Matthew-Otto/tiny-riscv/APR/tiny-riscv_layout.gif

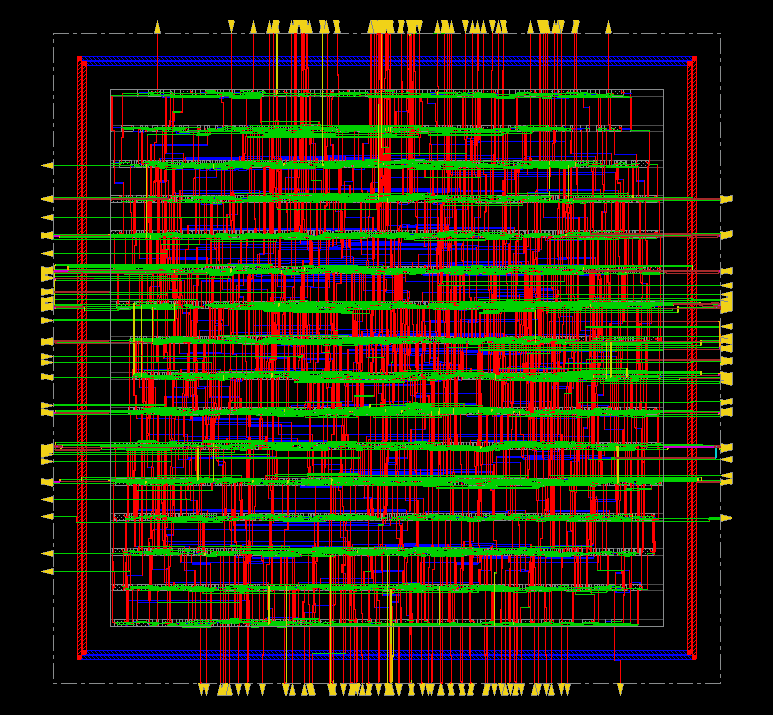
APR/tiny-riscv_layout.gif
