Matthew-Otto/tiny-riscv/RTL/top.sv

// Top module that includes a register file for simulation

module top (
    input  logic        clk,
    input  logic        rst,
    // instruction port
    output logic [31:0] i_addr,
    input  logic [31:0] i_rd_data,
    // data port
    output logic [31:0] d_addr,
    output logic [3:0]  d_we,
    output logic [31:0] d_wr_data,
    input  logic [31:0] d_rd_data
);

    // performance counters
    logic stall_execution;
    logic [31:0] cycle_count;
    logic [31:0] exec_count;

    assign stall_execution = core.control_i.flush | core.fetch_stall;

    always_ff @(posedge clk, posedge rst) begin
        if (rst)
            cycle_count <= 0;
        else
            cycle_count <= cycle_count + 1;
        
        if (rst)
            exec_count <= 0;
        else if (~stall_execution) 
            exec_count <= exec_count + 1;
    end

    logic        we;
    logic [4:0]  rd;
    logic [31:0] rd_data;
    logic [4:0]  rs1;
    logic [4:0]  rs2;
    logic [31:0] rs1_data;
    logic [31:0] rs2_data;

    core core (
        .clk,
        .rst,
        .i_addr,
        .i_rd_data,
        .d_addr,
        .d_we,
        .d_wr_data,
        .d_rd_data,
        .we,
        .rd,
        .rd_data,
        .rs1,
        .rs2,
        .rs1_data,
        .rs2_data
    );

    regfile regfile_i (
        .clk,
        .rst,
        .we,
        .rd,
        .rd_data,
        .rs1,
        .rs2,
        .rs1_data,
        .rs2_data
    );

endmodule : top
