Matthew-Otto/tiny-riscv/synthesis/design_vision/control.sv

// Generate control signals for core

module control (
    input  logic        flush,
    input  logic        is_writeback,
    input  logic        ld_valid,
    input  logic [4:0]  rs1,
    input  logic [4:0]  rs2,
    input  logic [4:0]  ld_rd,

    output logic        fetch_stall,
    output logic        reg_we,
    output logic        st_en,
    output logic        ld_en
);

    logic data_hazard;

    assign data_hazard = ld_valid & ((rs1 == ld_rd) | (rs2 == ld_rd));
    
    // dont writeback if branching (flush), or if fetch_stall (waiting on prev load) and instr is a non-load writeback
    assign reg_we = ~flush & ((~fetch_stall & is_writeback) | ld_valid); 

    assign st_en = ~(flush | data_hazard);
    assign ld_en = ~(flush | data_hazard);

    assign fetch_stall = (ld_valid & is_writeback) | data_hazard;



endmodule : control
