Matthew-Otto/tiny-riscv/synthesis/design_vision/synth_CSA.v

/////////////////////////////////////////////////////////////
// Created by: Synopsys DC Expert(TM) in wire load mode
// Version   : T-2022.03-SP2
// Date      : Sat Nov 29 13:05:06 2025
/////////////////////////////////////////////////////////////


module control ( flush, is_writeback, ld_valid, rs1, rs2, ld_rd, fetch_stall, 
        reg_we, st_en, ld_en );
  input [4:0] rs1;
  input [4:0] rs2;
  input [4:0] ld_rd;
  input flush, is_writeback, ld_valid;
  output fetch_stall, reg_we, st_en, ld_en;
  wire   st_en, n1, n2, n4, n5, n6, n7, n8, n9, n10, n11, n12, n13, n14, n15,
         n16, n17, n18, n19, n23, n24, n25, n26;
  assign ld_en = st_en;

  OAI21X1 U5 ( .A(flush), .B(n26), .C(n23), .Y(reg_we) );
  OAI21X1 U7 ( .A(n26), .B(n2), .C(n5), .Y(fetch_stall) );
  OAI21X1 U8 ( .A(n6), .B(n7), .C(ld_valid), .Y(n5) );
  NOR3X1 U9 ( .A(n24), .B(n9), .C(n10), .Y(n7) );
  XOR2X1 U10 ( .A(rs2[4]), .B(ld_rd[4]), .Y(n10) );
  XOR2X1 U11 ( .A(rs2[2]), .B(ld_rd[2]), .Y(n9) );
  NAND3X1 U12 ( .A(n11), .B(n12), .C(n13), .Y(n8) );
  XNOR2X1 U13 ( .A(ld_rd[1]), .B(rs2[1]), .Y(n13) );
  XNOR2X1 U14 ( .A(ld_rd[0]), .B(rs2[0]), .Y(n12) );
  XNOR2X1 U15 ( .A(ld_rd[3]), .B(rs2[3]), .Y(n11) );
  NOR3X1 U16 ( .A(n25), .B(n15), .C(n16), .Y(n6) );
  XOR2X1 U17 ( .A(rs1[4]), .B(ld_rd[4]), .Y(n16) );
  XOR2X1 U18 ( .A(rs1[3]), .B(ld_rd[3]), .Y(n15) );
  NAND3X1 U19 ( .A(n17), .B(n18), .C(n19), .Y(n14) );
  XNOR2X1 U20 ( .A(ld_rd[2]), .B(rs1[2]), .Y(n19) );
  XNOR2X1 U21 ( .A(ld_rd[1]), .B(rs1[1]), .Y(n18) );
  XNOR2X1 U22 ( .A(ld_rd[0]), .B(rs1[0]), .Y(n17) );
  AND2X1 U1 ( .A(is_writeback), .B(st_en), .Y(n4) );
  INVX1 U2 ( .A(n4), .Y(n23) );
  BUFX2 U3 ( .A(n8), .Y(n24) );
  BUFX2 U4 ( .A(n14), .Y(n25) );
  INVX1 U6 ( .A(ld_valid), .Y(n26) );
  INVX1 U23 ( .A(is_writeback), .Y(n2) );
  AND2X1 U24 ( .A(n5), .B(n1), .Y(st_en) );
  INVX1 U25 ( .A(flush), .Y(n1) );
endmodule


module full_adder_0 ( a, b, cin, sum, cout );
  input a, b, cin;
  output sum, cout;
  wire   n1, n2, n3;

  XOR2X1 U2 ( .A(n1), .B(n2), .Y(sum) );
  OAI21X1 U3 ( .A(n2), .B(n1), .C(n3), .Y(cout) );
  NAND2X1 U4 ( .A(a), .B(b), .Y(n3) );
  XNOR2X1 U5 ( .A(a), .B(b), .Y(n2) );
  INVX1 U1 ( .A(cin), .Y(n1) );
endmodule


module full_adder_63 ( a, b, cin, sum, cout );
  input a, b, cin;
  output sum, cout;
  wire   n1, n2, n3, n6;

  XOR2X1 U2 ( .A(n1), .B(n2), .Y(sum) );
  OAI21X1 U3 ( .A(n2), .B(n1), .C(n6), .Y(cout) );
  XNOR2X1 U5 ( .A(a), .B(b), .Y(n2) );
  AND2X1 U1 ( .A(a), .B(b), .Y(n3) );
  INVX1 U4 ( .A(n3), .Y(n6) );
  INVX1 U6 ( .A(cin), .Y(n1) );
endmodule


module full_adder_54 ( a, b, cin, sum, cout );
  input a, b, cin;
  output sum, cout;
  wire   n1, n2, n3;

  XOR2X1 U2 ( .A(n1), .B(n2), .Y(sum) );
  OAI21X1 U3 ( .A(n2), .B(n1), .C(n3), .Y(cout) );
  NAND2X1 U4 ( .A(a), .B(b), .Y(n3) );
  XNOR2X1 U5 ( .A(a), .B(b), .Y(n2) );
  INVX1 U1 ( .A(cin), .Y(n1) );
endmodule


module full_adder_33 ( a, b, cin, sum, cout );
  input a, b, cin;
  output sum, cout;
  wire   n7, n8, n9, n10;

  XOR2X1 U2 ( .A(n10), .B(n9), .Y(sum) );
  OAI21X1 U3 ( .A(n9), .B(n10), .C(n7), .Y(cout) );
  XNOR2X1 U5 ( .A(a), .B(b), .Y(n9) );
  AND2X1 U1 ( .A(a), .B(b), .Y(n8) );
  INVX1 U4 ( .A(n8), .Y(n7) );
  INVX1 U6 ( .A(cin), .Y(n10) );
endmodule


module full_adder_34 ( a, b, cin, sum, cout );
  input a, b, cin;
  output sum, cout;
  wire   n7, n8, n9, n10;

  XOR2X1 U2 ( .A(n10), .B(n9), .Y(sum) );
  OAI21X1 U3 ( .A(n9), .B(n10), .C(n7), .Y(cout) );
  XNOR2X1 U5 ( .A(a), .B(b), .Y(n9) );
  AND2X1 U1 ( .A(a), .B(b), .Y(n8) );
  INVX1 U4 ( .A(n8), .Y(n7) );
  INVX1 U6 ( .A(cin), .Y(n10) );
endmodule


module full_adder_35 ( a, b, cin, sum, cout );
  input a, b, cin;
  output sum, cout;
  wire   n7, n8, n9, n10;

  XOR2X1 U2 ( .A(n10), .B(n9), .Y(sum) );
  OAI21X1 U3 ( .A(n9), .B(n10), .C(n7), .Y(cout) );
  XNOR2X1 U5 ( .A(a), .B(b), .Y(n9) );
  AND2X1 U1 ( .A(a), .B(b), .Y(n8) );
  INVX1 U4 ( .A(n8), .Y(n7) );
  INVX1 U6 ( .A(cin), .Y(n10) );
endmodule


module full_adder_36 ( a, b, cin, sum, cout );
  input a, b, cin;
  output sum, cout;
  wire   n7, n8, n9;

  XOR2X1 U2 ( .A(n9), .B(n8), .Y(sum) );
  OAI21X1 U3 ( .A(n8), .B(n9), .C(n7), .Y(cout) );
  NAND2X1 U4 ( .A(a), .B(b), .Y(n7) );
  XNOR2X1 U5 ( .A(a), .B(b), .Y(n8) );
  INVX1 U1 ( .A(cin), .Y(n9) );
endmodule


module full_adder_51 ( a, b, cin, sum, cout );
  input a, b, cin;
  output sum, cout;
  wire   n7, n8, n9, n10;

  XOR2X1 U2 ( .A(n10), .B(n9), .Y(sum) );
  OAI21X1 U3 ( .A(n9), .B(n10), .C(n7), .Y(cout) );
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
  input a, b, cin;
  output sum, cout;
  wire   n6, n7, n8;

  XOR2X1 U2 ( .A(n8), .B(n7), .Y(sum) );
  OAI21X1 U3 ( .A(n7), .B(n8), .C(n6), .Y(cout) );
  NAND2X1 U4 ( .A(a), .B(b), .Y(n6) );
  XNOR2X1 U5 ( .A(a), .B(b), .Y(n7) );
  INVX1 U1 ( .A(cin), .Y(n8) );
endmodule


module full_adder_61 ( a, b, cin, sum, cout );
  input a, b, cin;
  output sum, cout;
  wire   n6, n7, n8;

  XOR2X1 U2 ( .A(n8), .B(n7), .Y(sum) );
  OAI21X1 U3 ( .A(n7), .B(n8), .C(n6), .Y(cout) );
  NAND2X1 U4 ( .A(a), .B(b), .Y(n6) );
  XNOR2X1 U5 ( .A(a), .B(b), .Y(n7) );
  INVX1 U1 ( .A(cin), .Y(n8) );
endmodule


module full_adder_62 ( a, b, cin, sum, cout );
  input a, b, cin;
  output sum, cout;
  wire   n6, n7, n8;

  XOR2X1 U2 ( .A(n8), .B(n7), .Y(sum) );
  OAI21X1 U3 ( .A(n7), .B(n8), .C(n6), .Y(cout) );
  NAND2X1 U4 ( .A(a), .B(b), .Y(n6) );
  XNOR2X1 U5 ( .A(a), .B(b), .Y(n7) );
  INVX1 U1 ( .A(cin), .Y(n8) );
endmodule


module fetch ( clk, rst, fetch_stall, is_br_type, br_type, take_branch, 
        rs1_data, imm_b, imm_i, imm_j, i_addr, PC_f, PC_e, flush );
  input [1:0] br_type;
  input [31:0] rs1_data;
  input [31:0] imm_b;
  input [31:0] imm_i;
  input [31:0] imm_j;
  output [31:0] i_addr;
  output [31:0] PC_f;
  output [31:0] PC_e;
  input clk, rst, fetch_stall, is_br_type, take_branch;
  output flush;
  wire   n495, n496, n497, n498, n499, n500, n501, n502, n503, n504, n505,
         n506, n507, n508, n509, n510, n511, n512, n513, n514, n515, n516,
         n517, n518, n519, n520, n521, n522, n523, n524, n525, n526, n527,
         n528, n529, n530, n531, n532, n533, n534, n535, n536, n537, n538,
         n539, n540, n541, n542, n543, n544, n545, n546, n547, n548, n549,
         n550, n551, n552, n553, n554, n555, n556, n557, n558, n559, n211,
         n214, n217, n220, n223, n226, n229, n232, n235, n238, n241, n244,
         n247, n250, n253, n256, n259, n262, n265, n268, n271, n274, n277,
         n280, n283, n286, n289, n292, n295, n298, n301, n304, n307, n1, n3,
         n4, n5, n6, n7, n8, n9, n10, n11, n12, n13, n14, n15, n16, n17, n18,
         n19, n20, n21, n22, n23, n24, n25, n26, n27, n28, n29, n30, n31, n32,
         n33, n34, n35, n36, n39, n40, n41, n42, n43, n44, n45, n46, n47, n48,
         n49, n50, n51, n52, n53, n54, n55, n56, n57, n58, n59, n60, n61, n62,
         n63, n64, n65, n66, n67, n68, n69, n70, n71, n72, n73, n74, n75, n76,
         n77, n78, n79, n80, n81, n82, n83, n84, n85, n86, n87, n88, n89, n90,
         n91, n92, n93, n94, n95, n96, n97, n98, n99, n100, n101, n102, n103,
         n104, n105, n106, n107, n108, n109, n110, n111, n112, n113, n114,
         n115, n116, n117, n118, n119, n120, n121, n122, n123, n124, n125,
         n126, n127, n128, n129, n130, n131, n132, n133, n134, n135, n136,
         n137, n138, n139, n140, n141, n142, n144, n145, n146, n147, n148,
         n149, n150, n151, n152, n153, n154, n155, n156, n157, n158, n159,
         n160, n161, n162, n163, n164, n165, n166, n167, n168, n169, n170,
         n171, n172, n173, n174, n175, n176, n177, n178, n180, n181, n182,
         n183, n184, n185, n186, n187, n188, n189, n190, n191, n192, n193,
         n194, n195, n196, n197, n198, n199, n200, n201, n202, n203, n204,
         n205, n206, n207, n208, n305, n308, n309, n310, n311, n312, n313,
         n314, n315, n316, n317, n318, n319, n320, n321, n322, n323, n324,
         n325, n326, n327, n328, n329, n330, n331, n332, n333, n334, n335,
         n336, n337, n338, n339, n560, n561, n562, n563, n564, n565, n566,
         n567, n568, n569, n570, n571, n572, n573, n574, n575, n576, n577,
         n578, n579, n580, n581, n582, n583, n584, n585, n586, n587, n588,
         n589, n590, n591, n592, n593, n594, n595, n596, n597, n598, n599,
         n600, n601, n602, n603, n604, n605, n606, n607, n608, n609, n610,
         n611, n612, n613, n614, n615, n616, n617, n618, n619, n620, n621,
         n622, n623, n624, n625, n626, n627, n628, n629, n630, n631, n632,
         n633, n634, n635, n636, n637, n638, n639, n640, n641, n642, n643,
         n644, n645, n646, n647, n648, n649, n650, n651, n660, n661, n662,
         n663, n664, n665, n666, n692, n693, n694, n695, n696, n697, n730,
         n731, n732, n733, n734, n735, n736, n737, n738, n739, n740, n741,
         n742, n743, n744, n745, n746, n747;
  wire   [31:0] next_PC;
  wire   [31:0] PC_addend1;
  wire   [32:1] carry;

  DFFSR flush_reg ( .D(n307), .CLK(clk), .R(1'b1), .S(n737), .Q(n559) );
  DFFSR \PC_f_reg[31]  ( .D(n304), .CLK(clk), .R(1'b1), .S(n737), .Q(n495) );
  DFFSR \PC_e_reg[31]  ( .D(i_addr[31]), .CLK(clk), .R(n735), .S(1'b1), .Q(
        n527) );
  DFFSR \PC_f_reg[30]  ( .D(n301), .CLK(clk), .R(n735), .S(1'b1), .Q(n496) );
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
  INVX1 U582 ( .A(PC_f[26]), .Y(n10) );
  INVX1 U583 ( .A(PC_f[27]), .Y(n9) );
  INVX1 U584 ( .A(PC_f[28]), .Y(n8) );
  INVX1 U585 ( .A(PC_f[29]), .Y(n7) );
  INVX1 U586 ( .A(PC_f[30]), .Y(n6) );
  INVX1 U587 ( .A(PC_f[31]), .Y(n5) );
  INVX1 U588 ( .A(br_type[0]), .Y(n41) );
endmodule


module decode ( instr, rd, rs1, rs2, is_writeback, alu_op, comp_op, subtract, 
        shift_right, shift_arith, is_auipc, is_load_op, load_op, is_store_op, 
        store_op, is_br_type, br_type, is_jump_op, is_imm, imm_b, imm_i, imm_s, 
        imm_u, imm_j );
  input [31:0] instr;
  output [4:0] rd;
  output [4:0] rs1;
  output [4:0] rs2;
  output [31:0] alu_op;
  output [2:0] comp_op;
  output [2:0] load_op;
  output [2:0] store_op;
  output [1:0] br_type;
  output [31:0] imm_b;
  output [31:0] imm_i;
  output [31:0] imm_s;
  output [31:0] imm_u;
  output [31:0] imm_j;
  output is_writeback, subtract, shift_right, shift_arith, is_auipc,
         is_load_op, is_store_op, is_br_type, is_jump_op, is_imm;
  wire   \instr[11] , \instr[10] , \instr[9] , \instr[8] , \instr[7] ,
         \instr[19] , \instr[18] , \instr[17] , \instr[16] , \instr[15] ,
         \instr[24] , \instr[23] , \instr[22] , \instr[21] , \instr[20] , n46,
         n47, n48, \instr[13] , \instr[12] , n49, \instr[3] , \instr[2] ,
         \instr[31] , \instr[30] , \instr[29] , \instr[28] , \instr[27] ,
         \instr[26] , \instr[25] , n1, n4, n6, n7, n9, n10, n11, n12, n13, n14,
         n15, n16, n17, n18, n19, n20, n21, n22, n23, n67, n50, n51, n52, n53,
         n55, n57, n61, n62, n63, n64, shift_right, n66;
  assign imm_j[0] = 1'b0;
  assign imm_u[0] = 1'b0;
  assign imm_u[1] = 1'b0;
  assign imm_u[2] = 1'b0;
  assign imm_u[3] = 1'b0;
  assign imm_u[4] = 1'b0;
  assign imm_u[5] = 1'b0;
  assign imm_u[6] = 1'b0;
  assign imm_u[7] = 1'b0;
  assign imm_u[8] = 1'b0;
  assign imm_u[9] = 1'b0;
  assign imm_u[10] = 1'b0;
  assign imm_u[11] = 1'b0;
  assign imm_b[0] = 1'b0;
  assign alu_op[3] = 1'b0;
  assign alu_op[4] = 1'b0;
  assign alu_op[5] = 1'b0;
  assign alu_op[6] = 1'b0;
  assign alu_op[7] = 1'b0;
  assign alu_op[8] = 1'b0;
  assign alu_op[9] = 1'b0;
  assign alu_op[10] = 1'b0;
  assign alu_op[11] = 1'b0;
  assign alu_op[12] = 1'b0;
  assign alu_op[13] = 1'b0;
  assign alu_op[14] = 1'b0;
  assign alu_op[15] = 1'b0;
  assign alu_op[16] = 1'b0;
  assign alu_op[17] = 1'b0;
  assign alu_op[18] = 1'b0;
  assign alu_op[19] = 1'b0;
  assign alu_op[20] = 1'b0;
  assign alu_op[21] = 1'b0;
  assign alu_op[22] = 1'b0;
  assign alu_op[23] = 1'b0;
  assign alu_op[24] = 1'b0;
  assign alu_op[25] = 1'b0;
  assign alu_op[26] = 1'b0;
  assign alu_op[27] = 1'b0;
  assign alu_op[28] = 1'b0;
  assign alu_op[29] = 1'b0;
  assign alu_op[30] = 1'b0;
  assign alu_op[31] = 1'b0;
  assign imm_s[4] = \instr[11] ;
  assign imm_b[4] = \instr[11] ;
  assign rd[4] = \instr[11] ;
  assign \instr[11]  = instr[11];
  assign imm_s[3] = \instr[10] ;
  assign imm_b[3] = \instr[10] ;
  assign rd[3] = \instr[10] ;
  assign \instr[10]  = instr[10];
  assign imm_s[2] = \instr[9] ;
  assign imm_b[2] = \instr[9] ;
  assign rd[2] = \instr[9] ;
  assign \instr[9]  = instr[9];
  assign imm_s[1] = \instr[8] ;
  assign imm_b[1] = \instr[8] ;
  assign rd[1] = \instr[8] ;
  assign \instr[8]  = instr[8];
  assign imm_s[0] = \instr[7] ;
  assign imm_b[11] = \instr[7] ;
  assign rd[0] = \instr[7] ;
  assign \instr[7]  = instr[7];
  assign imm_j[19] = \instr[19] ;
  assign imm_u[19] = \instr[19] ;
  assign rs1[4] = \instr[19] ;
  assign \instr[19]  = instr[19];
  assign imm_j[18] = \instr[18] ;
  assign imm_u[18] = \instr[18] ;
  assign rs1[3] = \instr[18] ;
  assign \instr[18]  = instr[18];
  assign imm_j[17] = \instr[17] ;
  assign imm_u[17] = \instr[17] ;
  assign rs1[2] = \instr[17] ;
  assign \instr[17]  = instr[17];
  assign imm_j[16] = \instr[16] ;
  assign imm_u[16] = \instr[16] ;
  assign rs1[1] = \instr[16] ;
  assign \instr[16]  = instr[16];
  assign imm_j[15] = \instr[15] ;
  assign imm_u[15] = \instr[15] ;
  assign rs1[0] = \instr[15] ;
  assign \instr[15]  = instr[15];
  assign imm_j[4] = \instr[24] ;
  assign imm_u[24] = \instr[24] ;
  assign imm_i[4] = \instr[24] ;
  assign rs2[4] = \instr[24] ;
  assign \instr[24]  = instr[24];
  assign imm_j[3] = \instr[23] ;
  assign imm_u[23] = \instr[23] ;
  assign imm_i[3] = \instr[23] ;
  assign rs2[3] = \instr[23] ;
  assign \instr[23]  = instr[23];
  assign imm_j[2] = \instr[22] ;
  assign imm_u[22] = \instr[22] ;
  assign imm_i[2] = \instr[22] ;
  assign rs2[2] = \instr[22] ;
  assign \instr[22]  = instr[22];
  assign imm_j[1] = \instr[21] ;
  assign imm_u[21] = \instr[21] ;
  assign imm_i[1] = \instr[21] ;
  assign rs2[1] = \instr[21] ;
  assign \instr[21]  = instr[21];
  assign imm_j[11] = \instr[20] ;
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
  assign imm_s[6] = \instr[26] ;
  assign imm_i[6] = \instr[26] ;
  assign imm_b[6] = \instr[26] ;
  assign \instr[26]  = instr[26];
  assign imm_j[5] = \instr[25] ;
  assign imm_u[25] = \instr[25] ;
  assign imm_s[5] = \instr[25] ;
  assign imm_i[5] = \instr[25] ;
  assign imm_b[5] = \instr[25] ;
  assign \instr[25]  = instr[25];
  assign load_op[2] = shift_right;
  assign store_op[2] = shift_right;
  assign imm_j[14] = shift_right;
  assign comp_op[2] = shift_right;
  assign imm_u[14] = shift_right;

  AOI21X1 U14 ( .A(n57), .B(n50), .C(n64), .Y(n49) );
  NAND3X1 U15 ( .A(\instr[30] ), .B(n13), .C(n14), .Y(n11) );
  NOR3X1 U16 ( .A(is_imm), .B(shift_right), .C(\instr[12] ), .Y(n14) );
  AOI21X1 U17 ( .A(n57), .B(n51), .C(n64), .Y(n48) );
  XNOR2X1 U19 ( .A(n1), .B(\instr[12] ), .Y(n16) );
  AOI21X1 U20 ( .A(n13), .B(n63), .C(is_br_type), .Y(n10) );
  NAND3X1 U22 ( .A(shift_right), .B(n9), .C(n53), .Y(n19) );
  NAND3X1 U25 ( .A(n9), .B(\instr[12] ), .C(n52), .Y(n21) );
  NAND3X1 U28 ( .A(\instr[2] ), .B(instr[5]), .C(n9), .Y(n18) );
  NOR3X1 U29 ( .A(instr[4]), .B(instr[6]), .C(n64), .Y(n23) );
  NOR3X1 U32 ( .A(is_imm), .B(instr[4]), .C(n4), .Y(is_br_type) );
  NOR3X1 U33 ( .A(n62), .B(instr[5]), .C(n7), .Y(is_auipc) );
  BUFX2 U3 ( .A(n11), .Y(n50) );
  AND2X1 U4 ( .A(n13), .B(n16), .Y(n15) );
  INVX1 U5 ( .A(n15), .Y(n51) );
  OR2X1 U6 ( .A(n63), .B(\instr[2] ), .Y(n22) );
  INVX1 U7 ( .A(n22), .Y(n52) );
  OR2X1 U8 ( .A(\instr[2] ), .B(\instr[12] ), .Y(n20) );
  INVX1 U9 ( .A(n20), .Y(n53) );
  BUFX2 U10 ( .A(n49), .Y(subtract) );
  BUFX2 U11 ( .A(n18), .Y(n55) );
  BUFX2 U12 ( .A(n48), .Y(alu_op[0]) );
  BUFX2 U13 ( .A(n10), .Y(n57) );
  AND2X2 U18 ( .A(n55), .B(n21), .Y(n46) );
  INVX1 U21 ( .A(n46), .Y(alu_op[2]) );
  AND2X2 U23 ( .A(n55), .B(n19), .Y(n47) );
  INVX1 U24 ( .A(n47), .Y(alu_op[1]) );
  AND2X1 U26 ( .A(n61), .B(n62), .Y(n67) );
  INVX1 U27 ( .A(n67), .Y(is_writeback) );
  AND2X1 U30 ( .A(\instr[2] ), .B(is_br_type), .Y(is_jump_op) );
  INVX1 U31 ( .A(is_jump_op), .Y(n61) );
  AND2X1 U34 ( .A(n13), .B(n6), .Y(n9) );
  INVX1 U35 ( .A(n9), .Y(n62) );
  OR2X1 U36 ( .A(n1), .B(shift_right), .Y(n17) );
  INVX1 U37 ( .A(n17), .Y(n63) );
  AND2X1 U38 ( .A(n7), .B(n6), .Y(n12) );
  INVX1 U39 ( .A(n12), .Y(n64) );
  AND2X1 U40 ( .A(is_imm), .B(n23), .Y(is_load_op) );
  INVX1 U41 ( .A(instr[5]), .Y(is_imm) );
  AND2X1 U42 ( .A(instr[4]), .B(n4), .Y(n13) );
  INVX1 U43 ( .A(n66), .Y(shift_right) );
  INVX1 U44 ( .A(instr[14]), .Y(n66) );
  AND2X1 U45 ( .A(instr[5]), .B(n23), .Y(is_store_op) );
  INVX1 U46 ( .A(\instr[13] ), .Y(n1) );
  INVX1 U47 ( .A(\instr[2] ), .Y(n7) );
  INVX1 U48 ( .A(instr[6]), .Y(n4) );
  INVX1 U49 ( .A(\instr[3] ), .Y(n6) );
endmodule


module full_adder_29 ( a, b, cin, sum, cout );
  input a, b, cin;
  output sum, cout;
  wire   n7, n8, n9, n10;

  XOR2X1 U2 ( .A(n10), .B(n9), .Y(sum) );
  OAI21X1 U3 ( .A(n9), .B(n10), .C(n7), .Y(cout) );
  XNOR2X1 U5 ( .A(a), .B(b), .Y(n9) );
  AND2X1 U1 ( .A(a), .B(b), .Y(n8) );
  INVX1 U4 ( .A(n8), .Y(n7) );
  INVX1 U6 ( .A(cin), .Y(n10) );
endmodule


module full_adder_30 ( a, b, cin, sum, cout );
  input a, b, cin;
  output sum, cout;
  wire   n7, n8, n9, n10;

  XOR2X1 U2 ( .A(n10), .B(n9), .Y(sum) );
  OAI21X1 U3 ( .A(n9), .B(n10), .C(n7), .Y(cout) );
  XNOR2X1 U5 ( .A(a), .B(b), .Y(n9) );
  AND2X1 U1 ( .A(a), .B(b), .Y(n8) );
  INVX1 U4 ( .A(n8), .Y(n7) );
  INVX1 U6 ( .A(cin), .Y(n10) );
endmodule


module full_adder_31 ( a, b, cin, sum, cout );
  input a, b, cin;
  output sum, cout;
  wire   n7, n8, n9, n10;

  XOR2X1 U2 ( .A(n10), .B(n9), .Y(sum) );
  OAI21X1 U3 ( .A(n9), .B(n10), .C(n7), .Y(cout) );
  XNOR2X1 U5 ( .A(a), .B(b), .Y(n9) );
  AND2X1 U1 ( .A(a), .B(b), .Y(n8) );
  INVX1 U4 ( .A(n8), .Y(n7) );
  INVX1 U6 ( .A(cin), .Y(n10) );
endmodule


module full_adder_32 ( a, b, cin, sum, cout );
  input a, b, cin;
  output sum, cout;
  wire   n7, n8, n9, n10;

  XOR2X1 U2 ( .A(n10), .B(n9), .Y(sum) );
  OAI21X1 U3 ( .A(n9), .B(n10), .C(n7), .Y(cout) );
  XNOR2X1 U5 ( .A(a), .B(b), .Y(n9) );
  AND2X1 U1 ( .A(a), .B(b), .Y(n8) );
  INVX1 U4 ( .A(n8), .Y(n7) );
  INVX1 U6 ( .A(cin), .Y(n10) );
endmodule


module csa_ripple_carry_adder_0 ( a, b, cin, s, cout );
  input [3:0] a;
  input [3:0] b;
  output [3:0] s;
  input cin;
  output cout;

  wire   [3:1] carries;

  full_adder_32 \RCA_BLOCK[0].fa  ( .a(a[0]), .b(b[0]), .cin(cin), .sum(s[0]), 
        .cout(carries[1]) );
  full_adder_31 \RCA_BLOCK[1].fa  ( .a(a[1]), .b(b[1]), .cin(carries[1]), 
        .sum(s[1]), .cout(carries[2]) );
  full_adder_30 \RCA_BLOCK[2].fa  ( .a(a[2]), .b(b[2]), .cin(carries[2]), 
        .sum(s[2]), .cout(carries[3]) );
  full_adder_29 \RCA_BLOCK[3].fa  ( .a(a[3]), .b(b[3]), .cin(carries[3]), 
        .sum(s[3]), .cout(cout) );
endmodule


module full_adder_18 ( a, b, cin, sum, cout );
  input a, b, cin;
  output sum, cout;
  wire   n7, n8, n9, n10;

  XOR2X1 U2 ( .A(n10), .B(n9), .Y(sum) );
  OAI21X1 U3 ( .A(n9), .B(n10), .C(n7), .Y(cout) );
  XNOR2X1 U5 ( .A(a), .B(b), .Y(n9) );
  AND2X1 U1 ( .A(a), .B(b), .Y(n8) );
  INVX1 U4 ( .A(n8), .Y(n7) );
  INVX1 U6 ( .A(cin), .Y(n10) );
endmodule


module full_adder_19 ( a, b, cin, sum, cout );
  input a, b, cin;
  output sum, cout;
  wire   n7, n8, n9, n10;

  XOR2X1 U2 ( .A(n10), .B(n9), .Y(sum) );
  OAI21X1 U3 ( .A(n9), .B(n10), .C(n7), .Y(cout) );
  XNOR2X1 U5 ( .A(a), .B(b), .Y(n9) );
  AND2X1 U1 ( .A(a), .B(b), .Y(n8) );
  INVX1 U4 ( .A(n8), .Y(n7) );
  INVX1 U6 ( .A(cin), .Y(n10) );
endmodule


module full_adder_20 ( a, b, cin, sum, cout );
  input a, b, cin;
  output sum, cout;
  wire   n7, n8, n9, n10;

  XOR2X1 U2 ( .A(n10), .B(n9), .Y(sum) );
  OAI21X1 U3 ( .A(n9), .B(n10), .C(n7), .Y(cout) );
  XNOR2X1 U5 ( .A(a), .B(b), .Y(n9) );
  AND2X1 U1 ( .A(a), .B(b), .Y(n8) );
  INVX1 U4 ( .A(n8), .Y(n7) );
  INVX1 U6 ( .A(cin), .Y(n10) );
endmodule


module full_adder_17 ( a, b, cin, sum, cout );
  input a, b, cin;
  output sum, cout;
  wire   n6, n7, n8, n9;

  XOR2X1 U2 ( .A(n9), .B(n8), .Y(sum) );
  OAI21X1 U3 ( .A(n8), .B(n9), .C(n6), .Y(cout) );
  XNOR2X1 U5 ( .A(a), .B(b), .Y(n8) );
  AND2X1 U1 ( .A(a), .B(b), .Y(n7) );
  INVX1 U4 ( .A(n7), .Y(n6) );
  INVX1 U6 ( .A(cin), .Y(n9) );
endmodule


module csa_ripple_carry_adder_5 ( a, b, cin, s, cout );
  input [3:0] a;
  input [3:0] b;
  output [3:0] s;
  input cin;
  output cout;

  wire   [3:1] carries;

  full_adder_20 \RCA_BLOCK[0].fa  ( .a(a[0]), .b(b[0]), .cin(cin), .sum(s[0]), 
        .cout(carries[1]) );
  full_adder_19 \RCA_BLOCK[1].fa  ( .a(a[1]), .b(b[1]), .cin(carries[1]), 
        .sum(s[1]), .cout(carries[2]) );
  full_adder_18 \RCA_BLOCK[2].fa  ( .a(a[2]), .b(b[2]), .cin(carries[2]), 
        .sum(s[2]), .cout(carries[3]) );
  full_adder_17 \RCA_BLOCK[3].fa  ( .a(a[3]), .b(b[3]), .cin(carries[3]), 
        .sum(s[3]), .cout(cout) );
endmodule


module full_adder_1 ( a, b, cin, sum, cout );
  input a, b, cin;
  output sum, cout;
  wire   n7, n8, n9, n10;

  XOR2X1 U2 ( .A(n10), .B(n9), .Y(sum) );
  OAI21X1 U3 ( .A(n9), .B(n10), .C(n7), .Y(cout) );
  XNOR2X1 U5 ( .A(a), .B(b), .Y(n9) );
  AND2X1 U1 ( .A(a), .B(b), .Y(n8) );
  INVX1 U4 ( .A(n8), .Y(n7) );
  INVX1 U6 ( .A(cin), .Y(n10) );
endmodule


module full_adder_2 ( a, b, cin, sum, cout );
  input a, b, cin;
  output sum, cout;
  wire   n7, n8, n9, n10;

  XOR2X1 U2 ( .A(n10), .B(n9), .Y(sum) );
  OAI21X1 U3 ( .A(n9), .B(n10), .C(n7), .Y(cout) );
  XNOR2X1 U5 ( .A(a), .B(b), .Y(n9) );
  AND2X1 U1 ( .A(a), .B(b), .Y(n8) );
  INVX1 U4 ( .A(n8), .Y(n7) );
  INVX1 U6 ( .A(cin), .Y(n10) );
endmodule


module full_adder_3 ( a, b, cin, sum, cout );
  input a, b, cin;
  output sum, cout;
  wire   n7, n8, n9, n10;

  XOR2X1 U2 ( .A(n10), .B(n9), .Y(sum) );
  OAI21X1 U3 ( .A(n9), .B(n10), .C(n7), .Y(cout) );
  XNOR2X1 U5 ( .A(a), .B(b), .Y(n9) );
  AND2X1 U1 ( .A(a), .B(b), .Y(n8) );
  INVX1 U4 ( .A(n8), .Y(n7) );
  INVX1 U6 ( .A(cin), .Y(n10) );
endmodule


module full_adder_4 ( a, b, cin, sum, cout );
  input a, b, cin;
  output sum, cout;
  wire   n7, n8, n9, n10;

  XOR2X1 U2 ( .A(n10), .B(n9), .Y(sum) );
  OAI21X1 U3 ( .A(n9), .B(n10), .C(n7), .Y(cout) );
  XNOR2X1 U5 ( .A(a), .B(b), .Y(n9) );
  AND2X1 U1 ( .A(a), .B(b), .Y(n8) );
  INVX1 U4 ( .A(n8), .Y(n7) );
  INVX1 U6 ( .A(cin), .Y(n10) );
endmodule


module csa_ripple_carry_adder_1 ( a, b, cin, s, cout );
  input [3:0] a;
  input [3:0] b;
  output [3:0] s;
  input cin;
  output cout;

  wire   [3:1] carries;

  full_adder_4 \RCA_BLOCK[0].fa  ( .a(a[0]), .b(b[0]), .cin(cin), .sum(s[0]), 
        .cout(carries[1]) );
  full_adder_3 \RCA_BLOCK[1].fa  ( .a(a[1]), .b(b[1]), .cin(carries[1]), .sum(
        s[1]), .cout(carries[2]) );
  full_adder_2 \RCA_BLOCK[2].fa  ( .a(a[2]), .b(b[2]), .cin(carries[2]), .sum(
        s[2]), .cout(carries[3]) );
  full_adder_1 \RCA_BLOCK[3].fa  ( .a(a[3]), .b(b[3]), .cin(carries[3]), .sum(
        s[3]), .cout(cout) );
endmodule


module full_adder_5 ( a, b, cin, sum, cout );
  input a, b, cin;
  output sum, cout;
  wire   n7, n8, n9, n10;

  XOR2X1 U2 ( .A(n10), .B(n9), .Y(sum) );
  OAI21X1 U3 ( .A(n9), .B(n10), .C(n7), .Y(cout) );
  XNOR2X1 U5 ( .A(a), .B(b), .Y(n9) );
  AND2X1 U1 ( .A(a), .B(b), .Y(n8) );
  INVX1 U4 ( .A(n8), .Y(n7) );
  INVX1 U6 ( .A(cin), .Y(n10) );
endmodule


module full_adder_6 ( a, b, cin, sum, cout );
  input a, b, cin;
  output sum, cout;
  wire   n7, n8, n9, n10;

  XOR2X1 U2 ( .A(n10), .B(n9), .Y(sum) );
  OAI21X1 U3 ( .A(n9), .B(n10), .C(n7), .Y(cout) );
  XNOR2X1 U5 ( .A(a), .B(b), .Y(n9) );
  AND2X1 U1 ( .A(a), .B(b), .Y(n8) );
  INVX1 U4 ( .A(n8), .Y(n7) );
  INVX1 U6 ( .A(cin), .Y(n10) );
endmodule


module full_adder_7 ( a, b, cin, sum, cout );
  input a, b, cin;
  output sum, cout;
  wire   n7, n8, n9, n10;

  XOR2X1 U2 ( .A(n10), .B(n9), .Y(sum) );
  OAI21X1 U3 ( .A(n9), .B(n10), .C(n7), .Y(cout) );
  XNOR2X1 U5 ( .A(a), .B(b), .Y(n9) );
  AND2X1 U1 ( .A(a), .B(b), .Y(n8) );
  INVX1 U4 ( .A(n8), .Y(n7) );
  INVX1 U6 ( .A(cin), .Y(n10) );
endmodule


module full_adder_8 ( a, b, cin, sum, cout );
  input a, b, cin;
  output sum, cout;
  wire   n7, n8, n9, n10;

  XOR2X1 U2 ( .A(n10), .B(n9), .Y(sum) );
  OAI21X1 U3 ( .A(n9), .B(n10), .C(n7), .Y(cout) );
  XNOR2X1 U5 ( .A(a), .B(b), .Y(n9) );
  AND2X1 U1 ( .A(a), .B(b), .Y(n8) );
  INVX1 U4 ( .A(n8), .Y(n7) );
  INVX1 U6 ( .A(cin), .Y(n10) );
endmodule


module csa_ripple_carry_adder_2 ( a, b, cin, s, cout );
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
  output sum, cout;
  wire   n7, n8, n9, n10;

  XOR2X1 U2 ( .A(n10), .B(n9), .Y(sum) );
  OAI21X1 U3 ( .A(n9), .B(n10), .C(n7), .Y(cout) );
  XNOR2X1 U5 ( .A(a), .B(b), .Y(n9) );
  AND2X1 U1 ( .A(a), .B(b), .Y(n8) );
  INVX1 U4 ( .A(n8), .Y(n7) );
  INVX1 U6 ( .A(cin), .Y(n10) );
endmodule


module full_adder_26 ( a, b, cin, sum, cout );
  input a, b, cin;
  output sum, cout;
  wire   n7, n8, n9, n10;

  XOR2X1 U2 ( .A(n10), .B(n9), .Y(sum) );
  OAI21X1 U3 ( .A(n9), .B(n10), .C(n7), .Y(cout) );
  XNOR2X1 U5 ( .A(a), .B(b), .Y(n9) );
  AND2X1 U1 ( .A(a), .B(b), .Y(n8) );
  INVX1 U4 ( .A(n8), .Y(n7) );
  INVX1 U6 ( .A(cin), .Y(n10) );
endmodule


module full_adder_27 ( a, b, cin, sum, cout );
  input a, b, cin;
  output sum, cout;
  wire   n7, n8, n9, n10;

  XOR2X1 U2 ( .A(n10), .B(n9), .Y(sum) );
  OAI21X1 U3 ( .A(n9), .B(n10), .C(n7), .Y(cout) );
  XNOR2X1 U5 ( .A(a), .B(b), .Y(n9) );
  AND2X1 U1 ( .A(a), .B(b), .Y(n8) );
  INVX1 U4 ( .A(n8), .Y(n7) );
  INVX1 U6 ( .A(cin), .Y(n10) );
endmodule


module full_adder_28 ( a, b, cin, sum, cout );
  input a, b, cin;
  output sum, cout;
  wire   n7, n8, n9, n10;

  XOR2X1 U2 ( .A(n10), .B(n9), .Y(sum) );
  OAI21X1 U3 ( .A(n9), .B(n10), .C(n7), .Y(cout) );
  XNOR2X1 U5 ( .A(a), .B(b), .Y(n9) );
  AND2X1 U1 ( .A(a), .B(b), .Y(n8) );
  INVX1 U4 ( .A(n8), .Y(n7) );
  INVX1 U6 ( .A(cin), .Y(n10) );
endmodule


module csa_ripple_carry_adder_7 ( a, b, cin, s, cout );
  input [3:0] a;
  input [3:0] b;
  output [3:0] s;
  input cin;
  output cout;

  wire   [3:1] carries;

  full_adder_28 \RCA_BLOCK[0].fa  ( .a(a[0]), .b(b[0]), .cin(cin), .sum(s[0]), 
        .cout(carries[1]) );
  full_adder_27 \RCA_BLOCK[1].fa  ( .a(a[1]), .b(b[1]), .cin(carries[1]), 
        .sum(s[1]), .cout(carries[2]) );
  full_adder_26 \RCA_BLOCK[2].fa  ( .a(a[2]), .b(b[2]), .cin(carries[2]), 
        .sum(s[2]), .cout(carries[3]) );
  full_adder_25 \RCA_BLOCK[3].fa  ( .a(a[3]), .b(b[3]), .cin(carries[3]), 
        .sum(s[3]), .cout(cout) );
endmodule


module carry_skip_adder ( a, b, sub, s, n, z, c, v );
  input [31:0] a;
  input [31:0] b;
  output [31:0] s;
  input sub;
  output n, z, c, v;
  wire   \CSKA_BLOCK[0].block_cout , \CSKA_BLOCK[1].block_cout ,
         \CSKA_BLOCK[2].block_cout , \CSKA_BLOCK[3].block_cout ,
         \CSKA_BLOCK[4].block_cout , \CSKA_BLOCK[5].block_cout ,
         \CSKA_BLOCK[6].block_cout , \CSKA_BLOCK[7].block_cout , n1, n2, n3,
         n4, n5, n6, n7, n9, n10, n11, n12, n13, n14, n15, n16, n17, n18, n19,
         n20, n21, n22, n23, n24, n25, n26, n27, n28, n29, n30, n31, n32, n33,
         n34, n35, n36, n37, n38, n39, n40, n41, n42, n43, n44, n45, n46, n47,
         n48, n49, n50, n51, n52, n53, n54, n55, n56, n57, n58, n59, n60, n61,
         n62, n63, n64, n65, n66, n67, n68, n69, n70, n71, n72, n73, n74, n75,
         n76, n77, n78, n79, n80, n81, n82, n83, n84, n85, n86, n126, n106,
         n107, n108, n109, n110, n111, n112, n113, n114, n116, n117, n118,
         n119, n120, n121, n122, n123, n124, n125;
  wire   [7:1] carries;
  wire   [31:0] b_mod;
  assign n = s[31];

  csa_ripple_carry_adder_0 \CSKA_BLOCK[0].rca  ( .a(a[3:0]), .b(b_mod[3:0]), 
        .cin(sub), .s(s[3:0]), .cout(\CSKA_BLOCK[0].block_cout ) );
  csa_ripple_carry_adder_7 \CSKA_BLOCK[1].rca  ( .a(a[7:4]), .b(b_mod[7:4]), 
        .cin(carries[1]), .s(s[7:4]), .cout(\CSKA_BLOCK[1].block_cout ) );
  csa_ripple_carry_adder_6 \CSKA_BLOCK[2].rca  ( .a(a[11:8]), .b(b_mod[11:8]), 
        .cin(n6), .s(s[11:8]), .cout(\CSKA_BLOCK[2].block_cout ) );
  csa_ripple_carry_adder_5 \CSKA_BLOCK[3].rca  ( .a(a[15:12]), .b(b_mod[15:12]), .cin(carries[3]), .s(s[15:12]), .cout(\CSKA_BLOCK[3].block_cout ) );
  csa_ripple_carry_adder_4 \CSKA_BLOCK[4].rca  ( .a(a[19:16]), .b(b_mod[19:16]), .cin(carries[4]), .s(s[19:16]), .cout(\CSKA_BLOCK[4].block_cout ) );
  csa_ripple_carry_adder_3 \CSKA_BLOCK[5].rca  ( .a(a[23:20]), .b(b_mod[23:20]), .cin(carries[5]), .s(s[23:20]), .cout(\CSKA_BLOCK[5].block_cout ) );
  csa_ripple_carry_adder_2 \CSKA_BLOCK[6].rca  ( .a(a[27:24]), .b(b_mod[27:24]), .cin(carries[6]), .s(s[27:24]), .cout(\CSKA_BLOCK[6].block_cout ) );
  csa_ripple_carry_adder_1 \CSKA_BLOCK[7].rca  ( .a(a[31:28]), .b(b_mod[31:28]), .cin(carries[7]), .s(s[31:28]), .cout(\CSKA_BLOCK[7].block_cout ) );
  NOR3X1 U27 ( .A(n106), .B(n110), .C(n109), .Y(z) );
  NOR3X1 U29 ( .A(n14), .B(s[14]), .C(s[13]), .Y(n13) );
  NOR3X1 U30 ( .A(n15), .B(s[10]), .C(s[0]), .Y(n12) );
  NOR3X1 U32 ( .A(n18), .B(s[21]), .C(s[20]), .Y(n17) );
  NOR3X1 U33 ( .A(n19), .B(s[18]), .C(s[17]), .Y(n16) );
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
  AND2X1 U141 ( .A(n85), .B(n86), .Y(n84) );
  AND2X1 U142 ( .A(n64), .B(n65), .Y(n63) );
  AND2X1 U143 ( .A(n57), .B(n58), .Y(n56) );
  AND2X1 U144 ( .A(n50), .B(n51), .Y(n49) );
  AND2X1 U145 ( .A(n43), .B(n44), .Y(n42) );
  AND2X1 U146 ( .A(n36), .B(n37), .Y(n35) );
endmodule
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
