Matthew-Otto/tiny-riscv/baseline/apr_run1/apr45nm.v

module INVX1 (A, Y);
input  A ;
output Y ;

endmodule



module INVX4 (Y, A);
input  A ;
output Y ;

endmodule



module AND2X1 (A, B, Y);
input  A ;
input  B ;
output Y ;

endmodule



module OR2X1 (A, B, Y);
input  A ;
input  B ;
output Y ;

endmodule
