Matthew-Otto/tiny-riscv/synthesis/design_vision/full_adder.sv

module full_adder (
    input  logic a,
    input  logic b,
    input  logic cin,
    output logic sum,
    output logic cout
);
    assign sum = a ^ b ^ cin;    
    assign cout = (a & b) | (b & cin) | (a & cin);

endmodule : full_adder
