Matthew-Otto/tiny-riscv/(commit log)

2025-10-06 improve skeleton, return to makefile sim flow
2025-10-28 start building synth flow
2025-10-28 synthesis flow working
2025-11-03 fix LD stall bug
    [LSU.sv, control.sv, core.sv, decode.sv, fetch.sv]
2025-11-03 fix a hazard bug
    [LSU.sv, control.sv, core.sv, decode.sv, fetch.sv]
2025-11-25 update benchmarks/verif to support spike, fix some bugs
    [ALU.sv, LSU.sv, control.sv, core.sv, decode.sv, fetch.sv, regfile.sv]
2025-11-30 tried carry skip adder, failed
    [ALU.sv, carry_skip_adder.sv, csa_ripple_carry_adder.sv, synth_CSA.v, top.sv]
